dolonche/-automated-water-supply-and-irrigation-system/В4.docx

Позиция | Наименование и техническая характеристика | Тип, марка, обозначение документа, опросного листа | Код оборудования, изделия, материала | Завод-изготовитель | Единица измерения | Количество | Масса единицы, кг | Примечания
1 | 2 | 3 | 4 | 5 | 6 | 7 | 8 | 9
| Обустройство КВАРД
| Щит управления
| Шкаф 600х800х250 | | AE 1058.500 | RITTAL | шт. | 1
| ПЛК150 | | | OWEN | шт. | 1
| МУ110-224.8К | | | OWEN | шт. | 1
| МВ110-220.8АС | | | OWEN | шт. | 1
| Автоматический выключатель 16А | | SZ 2364.000 | ABB | шт. | 2
| Автоматический выключатель | | SZ 2513.000 | ABB | шт. | 5
| Предохранительная клемма | | 3246418 | PHOENIX CONTACT | шт. | 14
| Клеммник винтовой проходной, 2.5мм.кв | | SK 3237.200 | PHOENIX CONTACT | шт. | 26
| Релейный модуль 24DC | | 2966210 | PHOENIX CONTACT | шт. | 8
| Релейный модуль 230AC | | 1079387 | PHOENIX CONTACT | шт. | 2
| Шильдик наружный | | | | шт. | 1
| Релейный модуль 24AC | | 2903306 | PHOENIX CONTACT | шт. | 7
| Концевой ограничитель | | 0800886 | | шт. | 26
| Клеммник винтовой проходной, 6мм.кв | | 3044131 | PHOENIX CONTACT | шт. | 11
| Клемма заземления, 6мм.кв | | 3044157 | PHOENIX CONTACT | шт. | 11
| Кулачковый переключатель | | | TDM Electric | шт. | 1
| Кабель-канал перфорированный 40х40 | | | | м | 1
| DIN-рейка | | | | м | 1
| Частотный преобразователь | | IDD751U21B | INNOVERT | шт. | 1
| Источник питания | | | | шт. | 1
| Трансформатор 220В - 24В, 40Вт | | | RICO Electric | шт. | 1
| Сенсорная панель MT8070iH 2WK | | | WIENTTEK | шт. | 1
| Сигнальная лампа зеленая 24В | | 1SFA619402R5022 | ABB | шт. | 1
| Сигнальная лампа красная 24В | | 1SFA616080R3071 | ABB | шт. | 1
| Кнопка аварийного останова 2НО | | CE4T-10R-20 | ABB | шт. | 1
| Карман для документов | | | RITTAL | шт. | 1
| Шина заземления | | SZ 2364.000 | RITTAL | шт. | 1

1.1.28 | Шина заземления | | SZ 2364.000 | RITTAL | шт. | 1
1.1.29 | Термостат | | SK 3110.000 | RITTAL | шт. | 1
1.1.30 | Выходной фильтр | | SK 3237.200 | RITTAL | шт. | 1
1.1.31 | Фильтрующий вентилятор | | SK 3237.100 | RITTAL | шт. | 1
1.1.32 | Кабель-канал перфорированный 25х30 | | | RITTAL | шт. | 1

НИУ МЭИ Р 1 2 Стадия Лист Листов Автоматизированная система автономного водоснабжения и полива ГИП Шестов Н.контр. Шилин Пров. Новиков Разраб. Питенин Изм. Лист Подпись Дата Кол.уч №док. Спецификация оборудования В4

2 Лист ВЛД.404632.001.05.В4 Изм. Лист Подпись Дата Кол.уч. №док.

14028-4/028 Инв. № Подл. Инв. № Подл. Инв. № Подл. Формат А3
