dolonche/-automated-water-supply-and-irrigation-system/В1.docx

Примечание:

1. Условные обозначения:

- Тип шкалы прибора:

- L – линейная.

- Тип сигнала по электрическим характеристикам:

- AI – аналоговый вход 4…20мА;

- AO – аналоговый выход 4…20мА;

- DI – дискретный вход =24В (сухой контакт), «0»/«1» состояние дискретных входов при поступлении сигнала;

- DO – дискретный выход =24В (сухой контакт);

- M-RS – Modbus RS

- Тип сигнала по уровню взрывозащиты (Ex):

- IS – искробезопасная цепь;

- NIS – не искробезопасная цепь.

-А/П – Тип сигнала:

- А – активный,

- П – пассивный.

-Пит. – питание из системы управления при типе сигнала А и извне при типе сигнала П:

- 24 – 24В постоянного тока,

- 230 – 230В переменного тока.

- 400 – 400В переменного тока.

- Функции АСУ ТП:

- Тип клапана:

- НО – нормально открытый клапан («воздух закрывает»),

- НЗ – нормально закрытый клапан («воздух открывает»);

- Регулирование, тип регулятора:

- П – прямого действия;

- О – обратного действия.

- БЛК – наличие блокировки;

- Сх. подкл. – Схема подключения:

- 2 – двухпроводная;

- 3 – трехпроводная;

- 4 – четырехпроводная.

Питание аналоговых сигналов и сигналов =24В осуществляется из АСУ ТП.

Позиция контура | | KKS | Наименование параметра | Номер техн. схемы | Значения переменной | | | | | | Шкала датчика | | Един. измерения | Тип сигнала | | | | Функции АСУТП | | | | Сх. подкл. | Примечание
| | | | | Блокировка | | Сигнализация | | | | Диапазон | Тип | | I/O | Ex | А/П | Пит. | Контроллер
| | | | | LL | HH | LL | L | H | HH | | | | | | | | Модуль:канал | НЗ/ НО | Рег. П/О | БЛК
1 | | 2 | 3 | 4 | 5 | 6 | 7 | 8 | 9 | 10 | 11 | 12 | 13 | 14 | 15 | 16 | 17 | 18 | 19 | 20 | 21 | 22 | 23
ME001 | | LDME001B01 | Срабатывание датчика дождя ME | | | | | | | | | | | DI | NIS | П | 24 AC | A1.0:DI5 | НЗ | | | 2 | Mini clik
PC001 | | LDPC001B08 | Показание датчика PIC | | | | | | | | 0.165…400 | L | Бар | AI | NIS | П | 24 DC | A1.0:AI1 | | | | 2 | ПД100
SV001 | | LDSV001A01 | Электромагнитный клапан SV1 открыть | | | | | | | | | | | DO | NIS | П | 24 AC | A1.2:DO1 | НО | | | 2 | K rain 7001-BSP-NFC
SV002 | | LDSV002A01 | Электромагнитный клапан SV2 открыть | | | | | | | | | | | DO | NIS | П | 24 AC | A1.2:DO2 | НО | | | 2
SV003 | | LDSV003A01 | Электромагнитный клапан SV3 открыть | | | | | | | | | | | DO | NIS | П | 24 AC | A1.2:DO3 | НО | | | 2
SV004 | | LDSV004A01 | Электромагнитный клапан SV4 открыть | | | | | | | | | | | DO | NIS | П | 24 AC | A1.2:DO4 | НО | | | 2
SV005 | | LDSV005A01 | Электромагнитный клапан SV5 открыть | | | | | | | | | | | DO | NIS | П | 24 AC | A1.2:DO5 | НО | | | 2
SV006 | | LDSV006A01 | Электромагнитный клапан SV6 открыть | | | | | | | | | | | DO | NIS | П | 24 AC | A1.2:DO6 | НО | | | 2
PR001 | | LDPR001B01 | Включить двигатель | | | | | | | | | | | DO | NIS | П | 220 AC | A1.2:DO7 | | | | | ECO FLOAT-3
PS001 | | LDPS001BL | Низкий уровень | | | | 1.3 | | | | 1…5.3 | L | Бар | DI | NIS | П | | A1.0:DI4 | | | | | PR-10
| | LDPS001BH | Высокий уровень | | | | | | | 2.6 | | L | Бар | DI | NIS | П
SP001 | | LDSP001A | Сенсорная панель RS-A | | | | | | | | | | | M-RS | NIS | | 24 DC | | | | | | Wientek Labs MT8070iH 2WK
| | LDSP001B | Сенсорная панель RS-B | | | | | | | | | | | M-RS | NIS | | 24 DC
AB001 | | LDAB001A01 | Авария (нажата кнопка аварийного останова) | | | | | | | | | | | DI | NIS | П | | A1.0:DI3
FV0001 | | LDFV001A08 | Управление двигателем (задание скорости) | | | | | | | | 0…100 | L | % | AO | NIS | П | | A1.0:AO1
SW001 | | LDSW001A | Силовой переключатель положение 1 | | | | | | | | | | | DI | NIS | | 220 AC | A1.0:DI1
| | LDSW001B | Силовой переключатель положение 2 | | | | | | | | | | | DI | NIS | | 220 AC | A1.0:DI2

НИУ МЭИ Р 1 2 Стадия Лист Листов Автоматизированная система автономного водоснабжения и полива Нач.отд. Шестов Н.контр. Шилин Пров. Новиков Разраб. Питенин Изм. Лист Подп. Дата Кол.уч. №док. Перечень входных и выходных сигналов В1

Инв. № подл. Взам. инв. № Подп. и дата Формат А3

Инв. № подл. Взам. инв. № Подп. и дата Формат А3 2 Лист Автоматизированная система автономного водоснабжения и полива Изм. Лист Подп. Дата Кол.уч. №док.
