dolonche/-automated-water-supply-and-irrigation-system/таблица 2 - соотношение количества входных-выходных сигналов .docx

Прибор | Дискретные входы | | Дискретные выходы | | Аналоговые входы | | Аналоговые выходы
| По факту | В проекте | По факту | В проекте | По факту | В проекте | По факту | В проекте
ПЛК 150 | 6 | 3 | 4 э/м реле | 8 | 4 | 1 | 2 | 1
МВ110-220 8АС | - | | - | | 8 | | -
МУ110 8k | - | | 8 | | - | | -
Итого | 6 | 3 | 12 | 8 | 12 | 1 | 2 | 1
