dolonche/-automated-water-supply-and-irrigation-system/таблица 1 - основные технические характеристики.docx

№ | Прибор | Ток коммутации | Тип сигнала | Потребляемый ток | Примечание
1 | Наос ECO FLOAT-3 | 5,5 А | DO | 5,5А
2 | Датчик дождя Mini clik | | DI | | Ток MAX 5А
3 | Электромагнитный клапан K rain 7001-BSP-NFC | | DO | | Пусковой ток: 0,43А. Номинальный ток: 0,25А.
4 | Реле давления PR-10 | 16 А | DI
5 | Преобразователь давления ПД100 | | AI | | 4-20 мА
6 | ПЧ | | AO
7 | ПЛК 150 | DO – 2А | | 0,06(81) А | AO - типы поддерживаемых сигналов: 0…5 мА, 0(4)…20 мА
8 | МУ110 8к | DO – 400 мА | | 0,0(36) А
9 | МВ110-220 8АС | | | 0,0(27) А
