dolonche/-automated-water-supply-and-irrigation-system/obshii-chertezh-mu110-8k.jpg

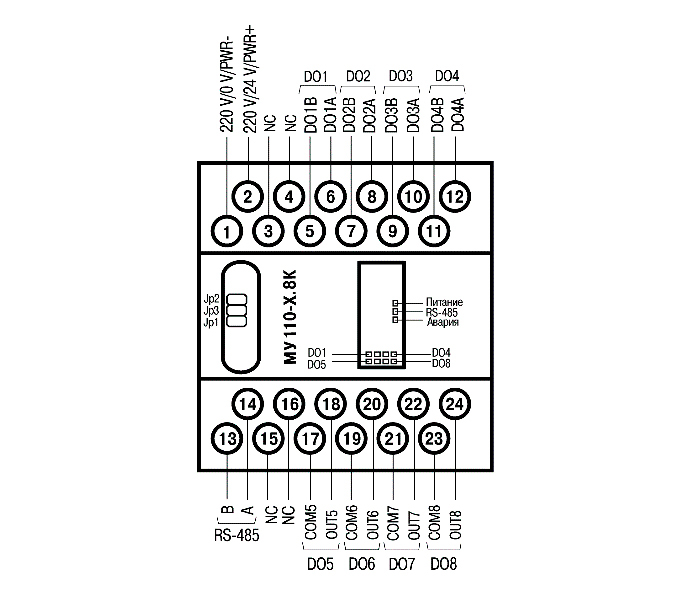
obshii-chertezh-mu110-8k.jpg
