dolonche/-automated-water-supply-and-irrigation-system/obshii-chertezh-mv110-8ac.jpg

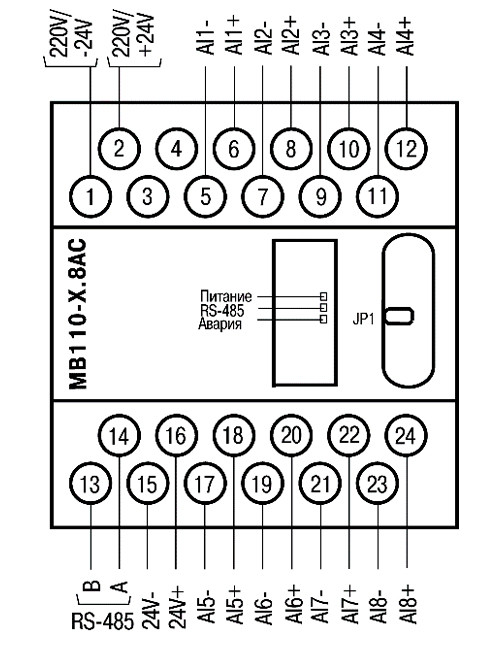
obshii-chertezh-mv110-8ac.jpg
