dolonche/-automated-water-supply-and-irrigation-system/shema_podklyucheniya_oven_plk150-220.jpg

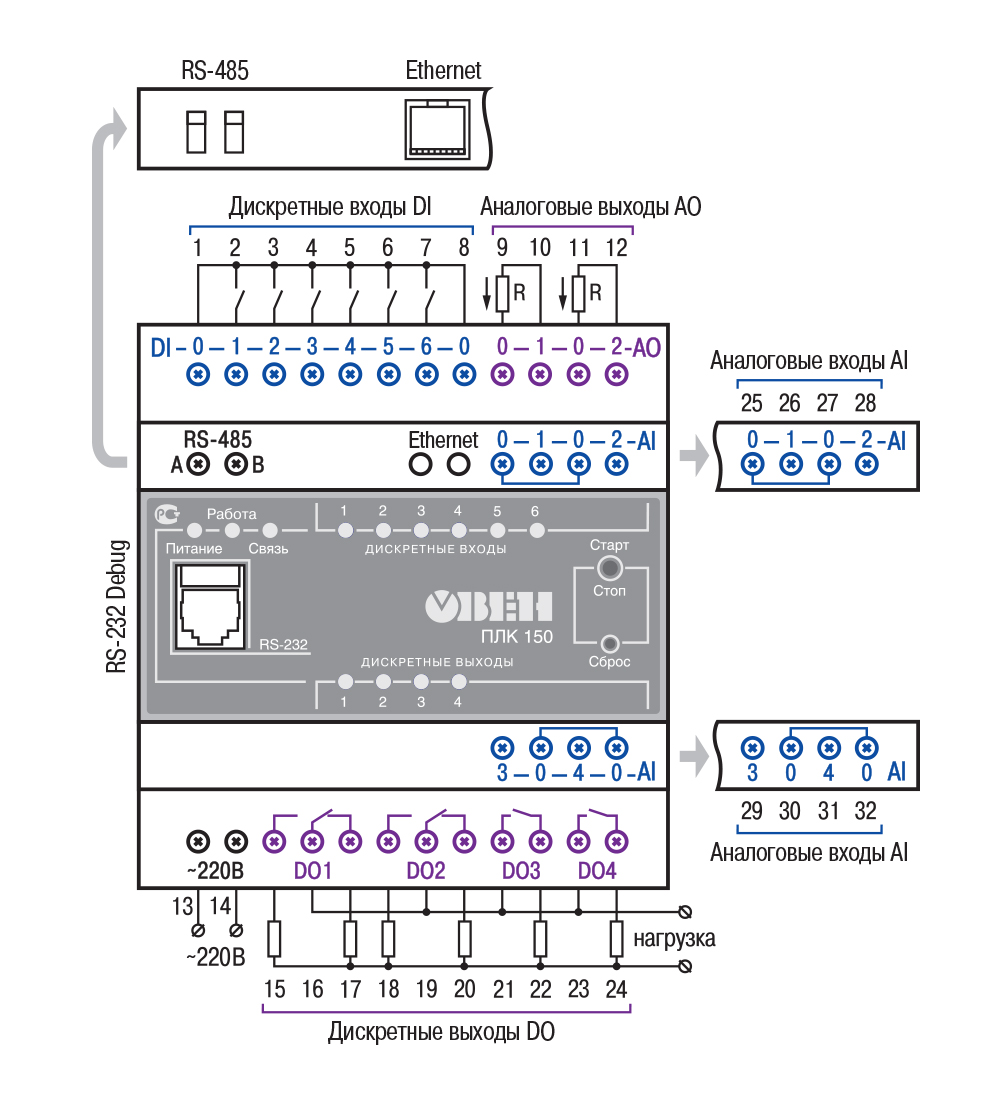
shema_podklyucheniya_oven_plk150-220.jpg
