dolonche/-automated-water-supply-and-irrigation-system/(list of files, cad)

Other CAD files:
С1.dwg
