dolonche/-automated-water-supply-and-irrigation-system/(commit log)

2020-12-02 fix в1
2020-12-06 update B1, C1 + B7 + П7
    [С1.dwg]
2020-12-08 upadate C1 + B1
    [С1.dwg]
2020-12-11 upadate C1 + B1 + add charge table
    [С1.dwg]
2020-12-13 fix schemes
    [С1.dwg]
2020-12-18 add new schemes
    [С1.dwg]
2020-12-22 update power circuit schemes + small fix
    [С1.dwg]
2020-12-30 update schemes + new table
    [С1.dwg, С1_recover.dwg]
2021-01-16 update schemes and word
    [С1.dwg]
2021-01-24 update schemes + start assembly drawing
    [С1.dwg, С1_recover.dwg]
2021-01-27 update schemes + process assembly drawing + update docs
    [С1.dwg]
2021-02-08 process assembly drawing
    [С1.dwg]
2021-02-11 process assembly drawing + fixes
    [С1.dwg]
2021-03-14 updat schemes + fix b4 + address sheet
    [address.xls]
2021-03-18 fix В4 + fix variables sheet
    [address.xls]
